iqbalhanif313/Rangkaian-Elektronika-Counter-Penghitung-Ayam-Otomatis/bengkel_elektronika(penghitung otomatis) bottom.brd.pdf

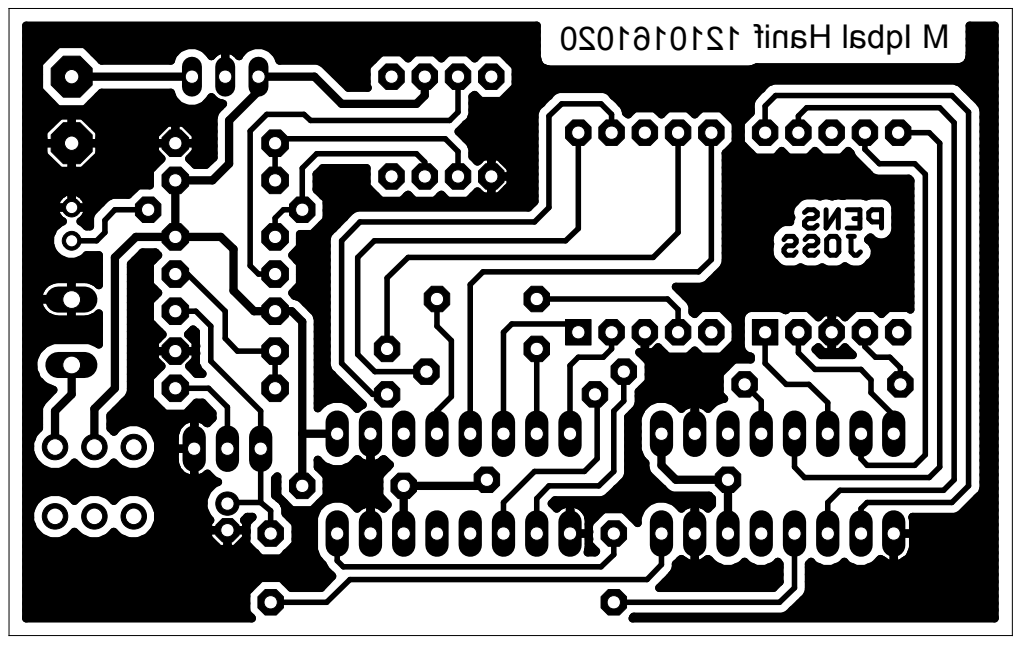
[picture p25: page 1]
1210161020 M Iqbal Hanif
