iqbalhanif313/Rangkaian-Elektronika-Counter-Penghitung-Ayam-Otomatis/bengkel_elektronika(penghitung otomatis).brd

## EAGLE design bengkel_elektronika(penghitung otomatis).brd (2018-12-09)

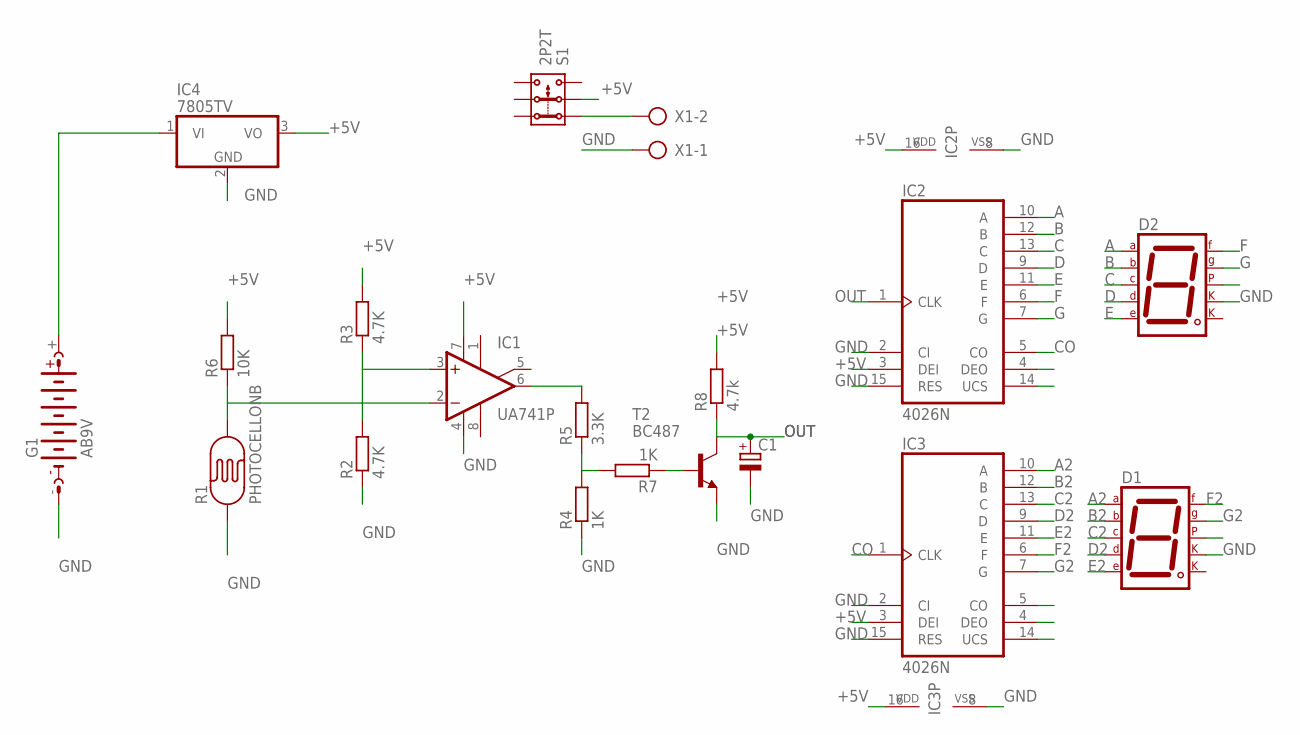
[picture p26: schematic bengkel_elektronika(penghitung otomatis).sch]

Parts:
C1: CPOL-EUE2-4; E2-4
D1, D2: 7SEG-CK; 7SEG-13
G1: AB9V
IC1: UA741P; DIL08
IC2, IC3: 4026N; DIL16
IC4: 7805TV; TO220V
R1: PHOTOCELLONB; ON_BOARD
R2, R3: 4.7K; 0207/7
R4, R7: 1K; 0207/7
R5: 3.3K; 0207/7
R6: 10K; 0207/7
R8: 4.7k; 0207/7
S1: 2P2T
T2: BC487; TO92-EBC
X1: AK500/2

Connections:
+5V: IC1.7 (V+), IC2.3 (DEI), IC2.16 (VDD), IC3.3 (DEI), IC3.16 (VDD), IC4.3 (VO), R3.2, R6.2, R8.2, S1.2.1
A: D2.7 (A), IC2.10 (A)
A2: D1.7 (A), IC3.10 (A)
B: D2.6 (B), IC2.12 (B)
B2: D1.6 (B), IC3.12 (B)
C: D2.4 (C), IC2.13 (C)
C2: D1.4 (C), IC3.13 (C)
CO: IC2.5 (CO), IC3.1 (CLK)
D: D2.2 (D), IC2.9 (D)
D2: D1.2 (D), IC3.9 (D)
E: D2.1 (E), IC2.11 (E)
E2: D1.1 (E), IC3.11 (E)
F: D2.9 (F), IC2.6 (F)
F2: D1.9 (F), IC3.6 (F)
G: D2.10 (G), IC2.7 (G)
G2: D1.10 (G), IC3.7 (G)
GND: C1.-, D1.3 (CK1), D2.3 (CK1), G1.-, IC1.4 (V-), IC2.2 (CI), IC2.8 (VSS), IC2.15 (RES), IC3.2 (CI), IC3.8 (VSS), IC3.15 (RES), IC4.2 (GND), R1.1, R2.1, R4.1, T2.E, X1.1
unnamed: IC1.2 (-IN), R1.2, R6.1
unnamed: IC1.3 (+IN), R2.2, R3.1
unnamed: IC1.6 (OUT), R5.2
unnamed: R4.2, R5.1, R7.2
unnamed: R7.1, T2.B
unnamed: S1.1.1, X1.2
unnamed: G1.+, IC4.1 (VI)
OUT: C1.+, IC2.1 (CLK), R8.1, T2.C

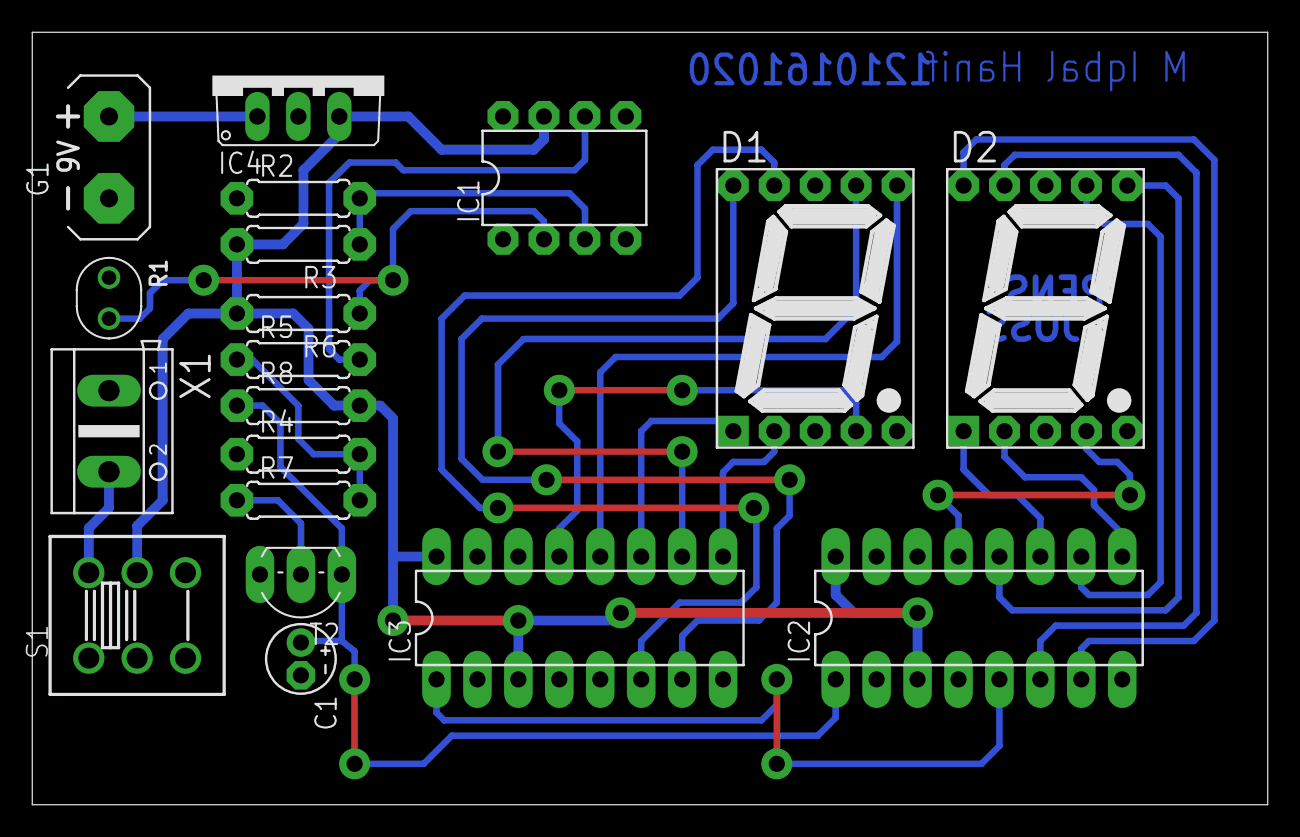
[picture p27: board bengkel_elektronika(penghitung otomatis).brd from above]

Board: 2 copper layers, 76.7 x 47.9 mm, 19 parts (0 on the bottom side), 25 nets.
